SarhanOsmanBhuiya/CSE499A-B-SENIOR-DESIGN-I-SENIOR-DESIGN-II/499B/Sudo-Code-to-Drive-the-Robot.docx

Sudo Code to Drive the Robot:

I want you guys to think about all the possibilities of the robot. I have been thinking for some days about this and got some outcomes. I can provide the code if you want but I don’t think that will help at this stage as we first should figure out all the real life possibilities then approach to the code. I am providing an example here.

1. Activate the robot
2. Servo_Cam start moving (0-90 degree; 45 degrees is straight)
3. If Servo_Cam detect any object in any particular direction goto 5
4. Else move_straight for 1 min and goto 2
5. Get the angle form the servo
6. If angle<45 then move_right
7. Else if angle>45 then move_left
8. Else if angle==45 move_straight

Note: here servo_cam, move_right, move_left, move_straight all are functions and proper conditions will be applied.

Task: Just think individually what else the robot should do (not how). Feel free to give suggestions about arrangements of the task. For instance, you can say robot should move_straight after activating rather than servo_cam movement. I will take the best suggestion. Thanks all.
