SarhanOsmanBhuiya/CSE499A-B-SENIOR-DESIGN-I-SENIOR-DESIGN-II/72981093_419546345378483_6468167932563161088_n.jpg

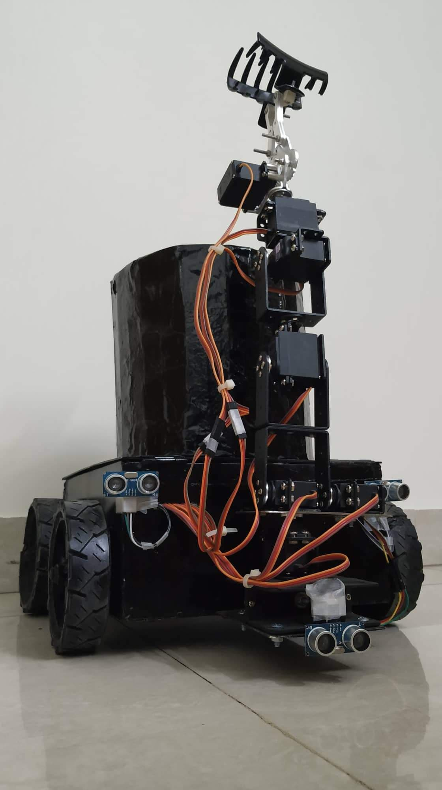
72981093_419546345378483_6468167932563161088_n.jpg
