SarhanOsmanBhuiya/CSE499A-B-SENIOR-DESIGN-I-SENIOR-DESIGN-II/SUB-Section Reports/Economic and Social Impact of the Project Report/70687078_546934409382732_8290643841837432832_n.jpg

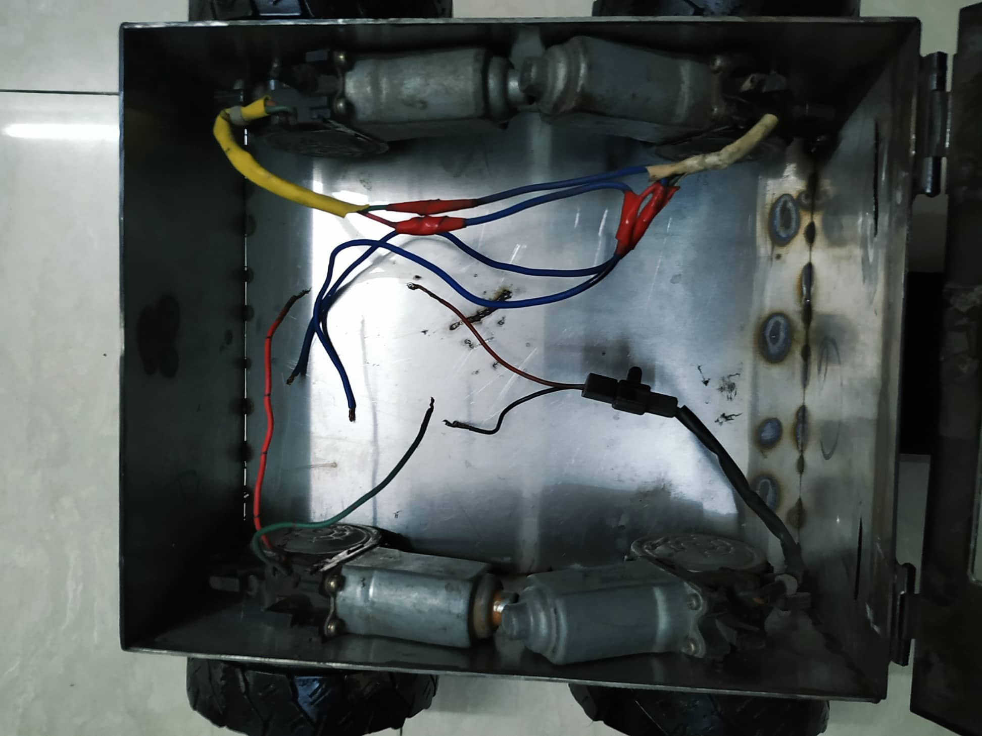
SUB-Section Reports/Economic and Social Impact of the Project Report/70687078_546934409382732_8290643841837432832_n.jpg
