SarhanOsmanBhuiya/CSE499A-B-SENIOR-DESIGN-I-SENIOR-DESIGN-II/SUB-Section Reports/Economic and Social Impact of the Project Report/71216931_1384031708432548_7109547248689610752_n.jpg

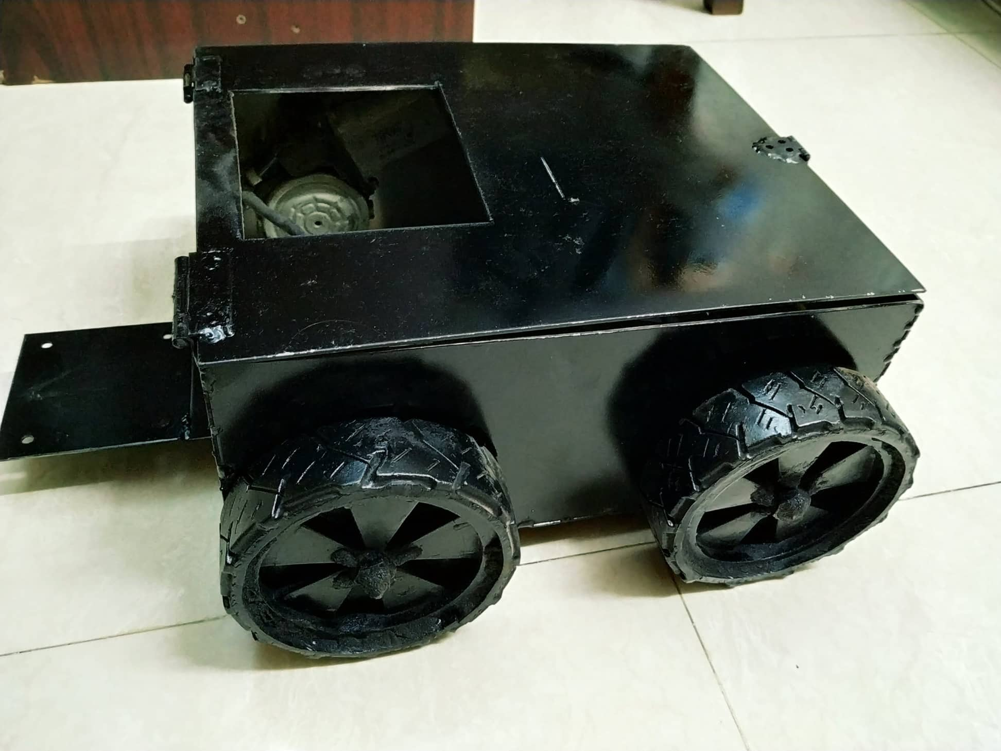
SUB-Section Reports/Economic and Social Impact of the Project Report/71216931_1384031708432548_7109547248689610752_n.jpg
