SarhanOsmanBhuiya/CSE499A-B-SENIOR-DESIGN-I-SENIOR-DESIGN-II/499A/Components.docx

Components | Price | Report price
Raspberry pi 3 B+ | 4390 | 3850
Pi Case | 500 | 430
Memory card | 550 | 550
Heat sink | 50 | 50
Sonar(4) | 90* 4=360 | 90*4=360
Robot car chassis | 930 | 800
Robotic arm with servo motor | 6500 | 5500
Arduino UNO | 405 | 350
Arduino MEGA | 770 | 700
Motor shield | 480 | 300
Power bank 2 | 1500*2=3000 | 1100*2=2200
Pi Camera | 1290 | 1000
